Siliasdotorg/Maschinenbrau/README.md

Dies ist das GitHub der Maschinenbrauer. Zu unserem Blogeintrag: ***Logo klicken*** 

Maschinenbrau_braun_notext (https://hobbybrauer.de/forum/viewtopic.php?t=33841)
