Siliasdotorg/Maschinenbrau/Step-Dateien/ALuprofil_Eimerhalter_extrastabil.stl

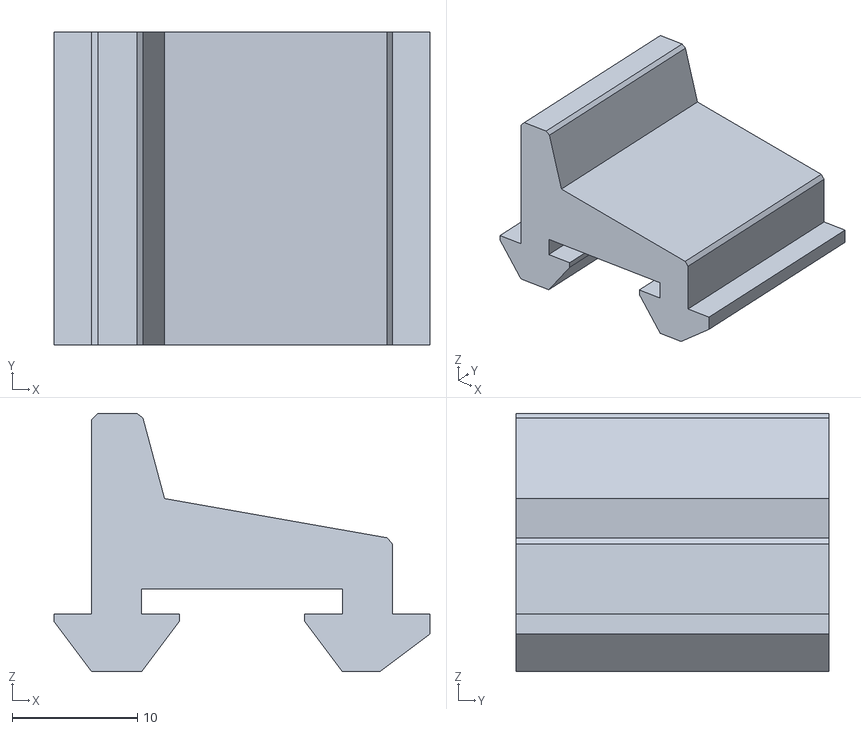
[picture p1: CAD file, 2024-04-10]
Step-Dateien/ALuprofil_Eimerhalter_extrastabil.stl
30.0 x 25.0 x 20.6
