Siliasdotorg/Maschinenbrau/Step-Dateien/Aluprofil_Eimerhalter.stl

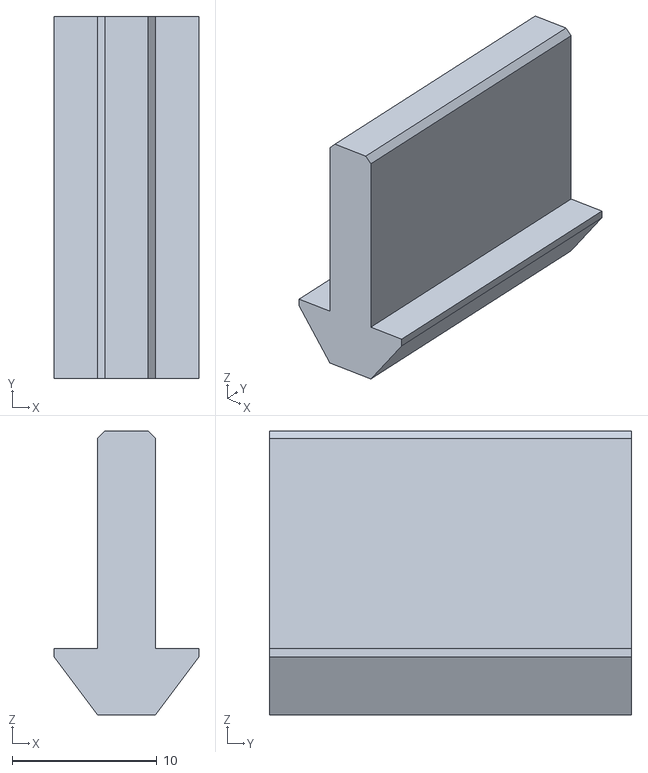
[picture p2: CAD file, 2024-04-10]
Step-Dateien/Aluprofil_Eimerhalter.stl
10.0 x 25.0 x 19.6
