Siliasdotorg/Maschinenbrau/Step-Dateien/Pumpenhalter.stl

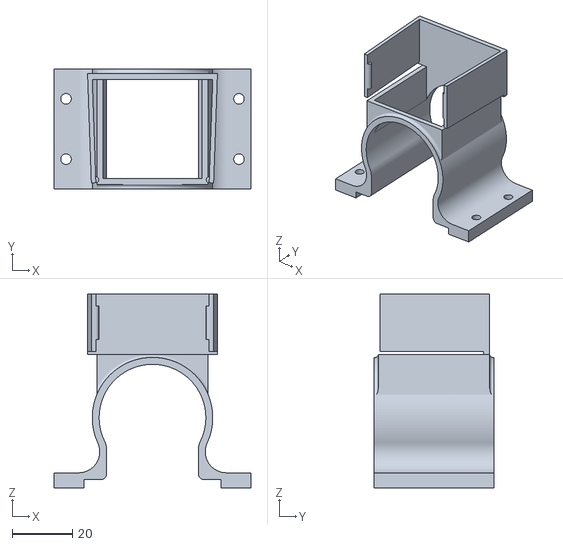
[picture p3: CAD file, 2024-04-10]
Step-Dateien/Pumpenhalter.stl
65.4 x 40.0 x 64.3
