Siliasdotorg/Maschinenbrau/Step-Dateien/Aluprofil_Eimerhalter_lang.stl

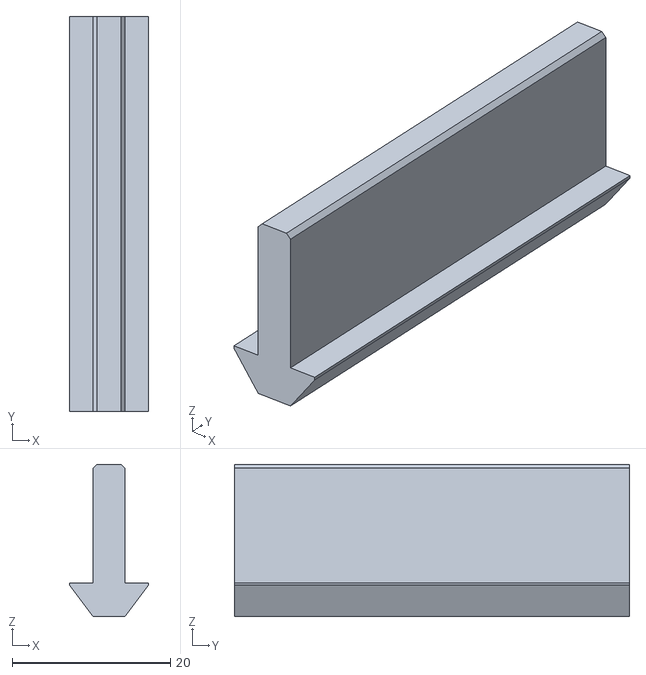
[picture p4: CAD file, 2024-04-10]
Step-Dateien/Aluprofil_Eimerhalter_lang.stl
10.0 x 50.0 x 19.3
