Siliasdotorg/Maschinenbrau/Step-Dateien/Hose Clamp - Hose Clamp.stl

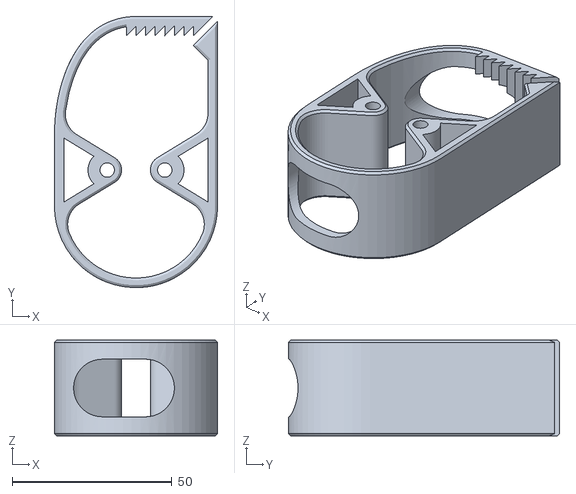
[picture p5: CAD file, 2024-04-10]
Step-Dateien/Hose Clamp - Hose Clamp.stl
51.0 x 84.7 x 30.0
