Siliasdotorg/Maschinenbrau/(commit log)

2024-04-10 Neuer Ordner für die Step Dateien für den 3D Druck.
    [Hose Clamp - Hose Clamp.stl]
2024-04-10 Add files via upload
    Das sind die STL files
    [ALuprofil_Eimerhalter_extrastabil.stl, Aluprofil_Eimerhalter.stl, Aluprofil_Eimerhalter_lang.stl, Pumpenhalter.stl]
